ChicoLiebl/pressure-acquisition-system/README.md

# pressure-acquisition-system

Acquisition system for a piezoelectric pressure sensor, model 601A from Kistler. This system was developed as my electrical engineering graduation project.
