ChicoLiebl/pressure-acquisition-system/Hardware/local-lib/cad_models/hlk-pm01--3DModel-STEP-56544.STEP

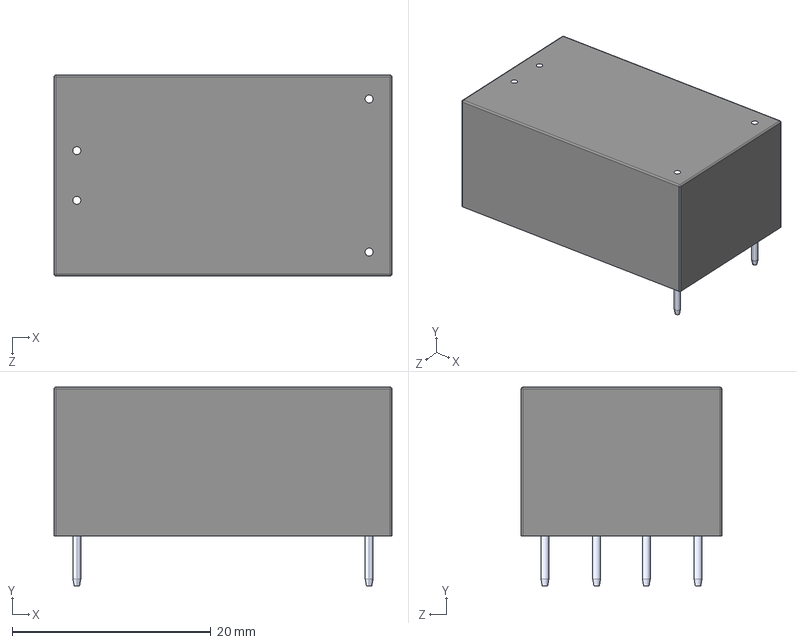
[picture p1: CAD file, 2021-12-02]
Hardware/local-lib/cad_models/hlk-pm01--3DModel-STEP-56544.STEP
34.0 x 20.0 x 20.2 mm
