ChicoLiebl/pressure-acquisition-system/Hardware/local-lib/cad_models/Common-mode-choke.STEP

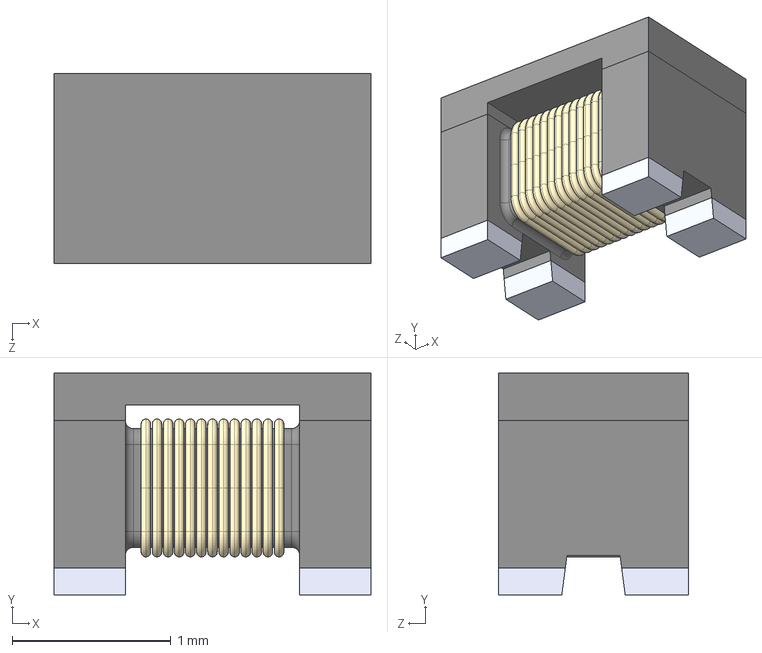
[picture p2: CAD file, 2021-12-02]
Hardware/local-lib/cad_models/Common-mode-choke.STEP
2.00 x 1.40 x 1.20 mm
