ChicoLiebl/pressure-acquisition-system/Hardware/local-lib/cad_models/BNC7T-J-P-HN-RA-BH1.stp

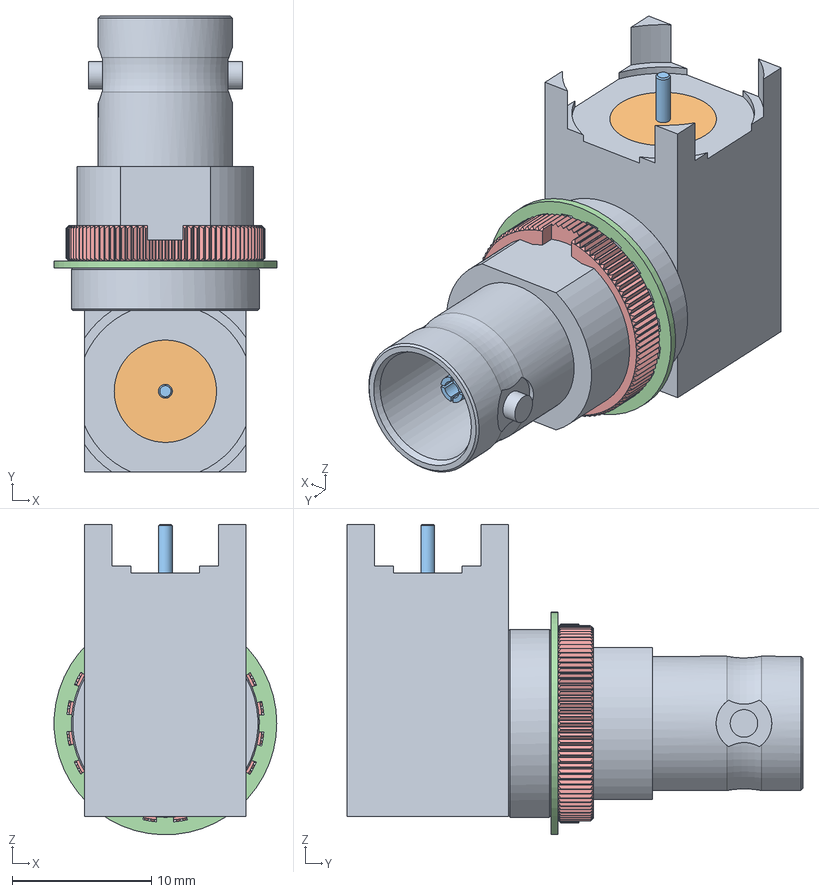
[picture p3: CAD file, 2021-12-02]
Hardware/local-lib/cad_models/BNC7T-J-P-HN-RA-BH1.stp
16.0 x 32.8 x 22.3 mm
_BNC7T-G-P-HN-RA-BH1_s
_BNC7T-G-P-HN-RA-BH1_i
_BNC7T-G-P-HN-RA-BH1_p
_BNC7T-G-P-HN-RA-BH1_w
_BNC7T-G-P-HN-RA-BH1_n
