ChicoLiebl/pressure-acquisition-system/Hardware/local-lib/cad_models/ESP32-WROVER-I.step

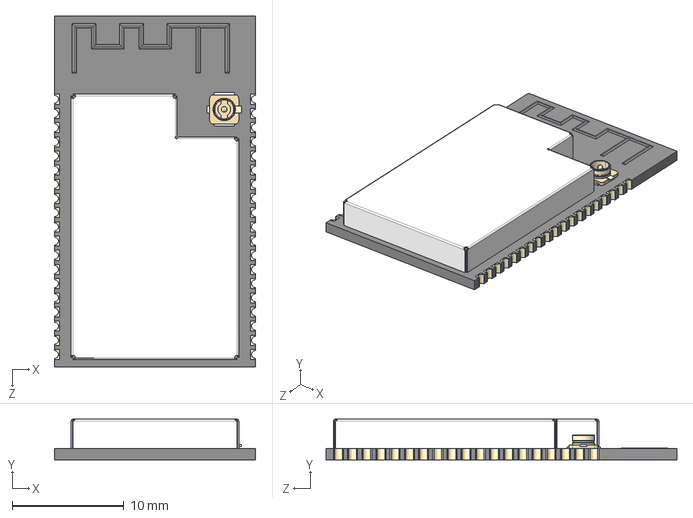
[picture p4: CAD file, 2021-12-02]
Hardware/local-lib/cad_models/ESP32-WROVER-I.step
18.0 x 3.65 x 31.4 mm
