ChicoLiebl/pressure-acquisition-system/Hardware/REV00/stencil.stl

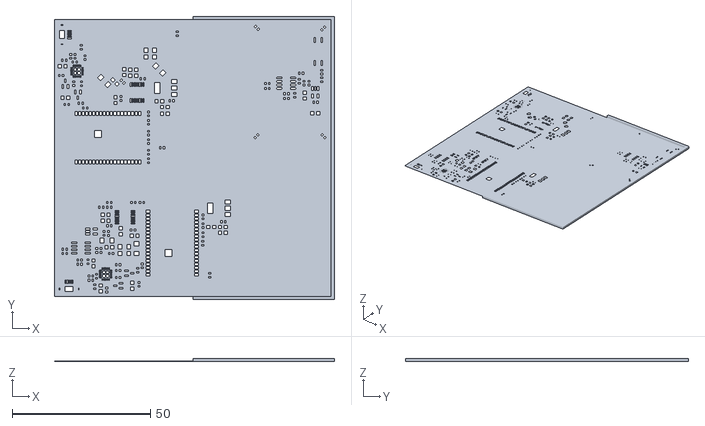
[picture p5: CAD file, 2021-12-02, an earlier design]
Hardware/REV00/stencil.stl
101.2 x 102.4 x 1.20
