ChicoLiebl/pressure-acquisition-system/Hardware/V2-main-board/V2-main-board.kicad_pcb

## KiCad design Hardware/V2-main-board/V2-main-board.kicad_pcb (2021-12-02)

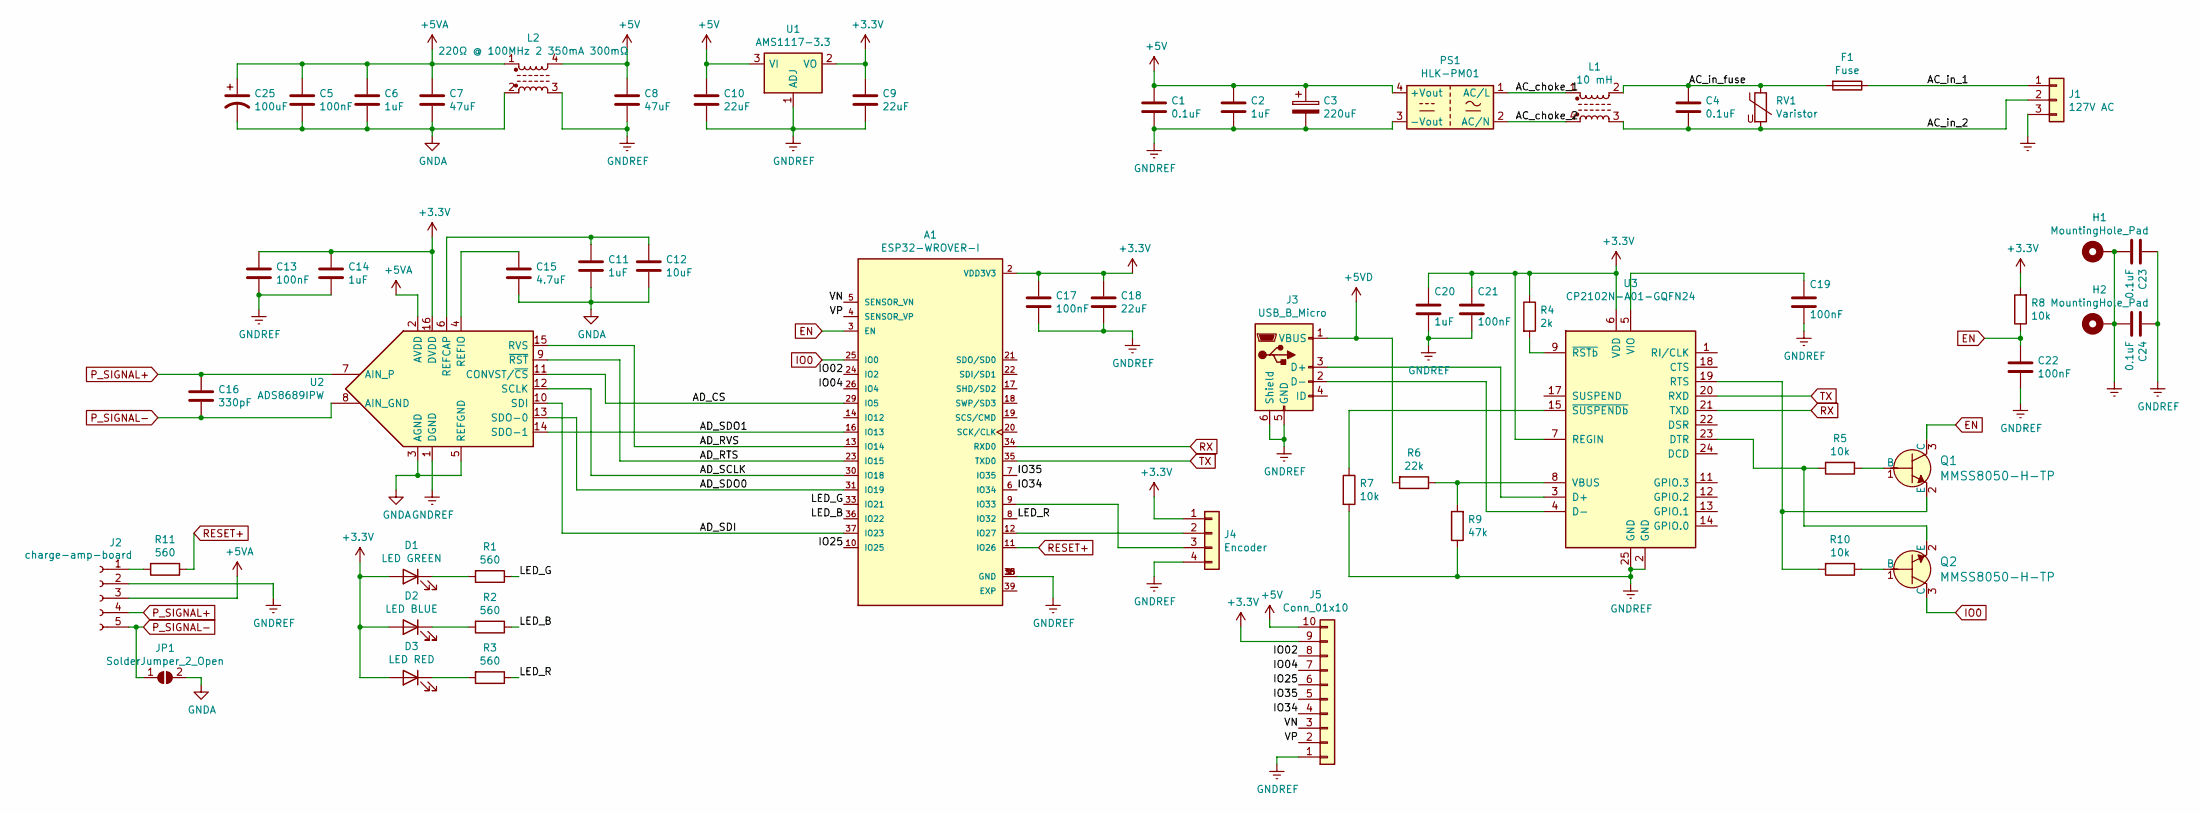
[picture p6: schematic V2-main-board.sch]

Parts:
A1: ESP32-WROVER-I; XCVR_ESP32-WROVER-I; DIGI-KEY_PART_NUMBER 1904-1008-1-ND
C1, C23, C24: 0.1uF; 0603
C2, C6, C11, C14, C20: 1uF; 0805
C3: 220uF; CP_Radial_D10.0mm_P2.50mm
C4: 0.1uF; C_Rect_L9.0mm_W3.8mm_P7.50mm_MKT
C5, C13, C17, C19, C21, C22: 100nF; 0603
C7, C8: 47uF; 1206
C9, C10, C18: 22uF; 0805
C12: 10uF; 0805
C15: 4.7uF; 0805
C16: 330pF; 0603
C25: 100uF; CP_Radial_D5.0mm_P2.00mm
D1: LED GREEN; 0603
D2: LED BLUE; 0603
D3: LED RED; 0603
F1: Fuse; Fuse_BelFuse_0ZRE0025FF_L9.6mm_W3.8mm
H1, H2: MountingHole_Pad; TestPoint_Plated_Hole_D3.0mm
J1: 127V AC; AC-Input
J2: charge-amp-board; GX16-5P
J3: USB_B_Micro; USB_Micro-AB_Molex_47590-0001
J4: Encoder; PinHeader_1x04_P1.27mm_Vertical
J5: Conn_01x10; PinHeader_1x10_P2.54mm_Vertical
JP1: SolderJumper_2_Open; SolderJumper-2_P1.3mm_Open_RoundedPad1.0x1.5mm
L1: 10 mH; UU9.8
L2: 220Ω @ 100MHz 2 350mA 300mΩ; ACM3225-2P
PS1: HLK-PM01; Converter_ACDC_HiLink_HLK-PMxx
Q1, Q2: MMSS8050-H-TP; SOT-23-3; MPN MMSS8050-H-TP; Digi-Key_PN MMSS8050-H-TPMSCT-ND
R1, R2, R3, R11: 560; 0603
R4: 2k; 0603
R5, R7, R8, R10: 10k; 0603
R6: 22k; 0603
R9: 47k; 0603
RV1: Varistor; RV_Disc_D12mm_W3.9mm_P7.5mm
U1: AMS1117-3.3; SOT-223-3_TabPin2
U2: ADS8689IPW; TSSOP-16_4.4x5mm_P0.65mm
U3: CP2102N-A01-GQFN24; QFN-24-1EP_4x4mm_P0.5mm_EP2.6x2.6mm

Connections:
+3V3: A1.2 (VDD3V3), C9.1, C13.1, C14.1, C17.1, C18.1, C20.1, C21.1, D1.2 (A), D2.2 (A), D3.2 (A), J4.1, J5.9, R4.1, R8.2, U1.2 (VO), U2.16 (DVDD), U3.6 (VDD), U3.7 (REGIN)
+5V: C1.1, C2.1, C3.1, C8.1, C10.1, J5.10, L2.4, PS1.4 (+Vout), U1.3 (VI)
+5VA: C5.1, C6.1, C7.1, C25.1, J2.3, L2.1, U2.2 (AVDD)
+5VD: J3.1 (VBUS), R6.2
/AC_choke_1: L1.1, PS1.1 (AC/L)
/AC_choke_2: L1.4, PS1.2 (AC/N)
/AC_in_1: F1.1, J1.1
/AC_in_2: C4.2, J1.2, L1.3, RV1.2
/AC_in_fuse: C4.1, F1.2, L1.2, RV1.1
/AD_CS: A1.29 (IO5), U2.11 (CONVST/~CS)
/AD_RTS: A1.23 (IO15), U2.9 (~RST)
/AD_RVS: A1.13 (IO14), U2.15 (RVS)
/AD_SCLK: A1.30 (IO18), U2.12 (SCLK)
/AD_SDI: A1.37 (IO23), U2.10 (SDI)
/AD_SDO0: A1.31 (IO19), U2.13 (SDO-0)
/AD_SDO1: A1.16 (IO13), U2.14 (SDO-1)
/IO02: A1.24 (IO2), J5.8
/IO04: A1.26 (IO4), J5.7
/IO25: A1.10 (IO25), J5.6
/IO34: A1.6 (IO34), J5.4
/IO35: A1.7 (IO35), J5.5
/LED_B: A1.36 (IO22), R2.1
/LED_G: A1.33 (IO21), R1.1
/LED_R: A1.8 (IO32), R3.1
/VN: A1.5 (SENSOR_VN), J5.3
/VP: A1.4 (SENSOR_VP), J5.2
EN: A1.3 (EN), C22.1, Q1.3 (C), R8.1
Earth: C23.2, C24.2, H1.1, H2.1, J1.3
GNDA: C5.2, C6.2, C7.2, C11.2, C12.2, C15.2, C25.2, JP1.2 (B), L2.2, U2.3 (AGND), U2.5 (REFGND)
GNDREF: A1.1 (GND), A1.15 (GND), A1.38 (GND), C1.2, C2.2, C3.2, C8.2, C9.2, C10.2, C13.2, C14.2, C17.2, C18.2, C19.2, C20.2, C21.2, C22.2, C23.1, C24.1, J2.2, J3.5 (GND), J3.6 (Shield), J4.4, J5.1, L2.3, PS1.3 (-Vout), R7.2, R9.1, U1.1 (ADJ), U2.1 (DGND), U3.2 (GND), U3.25 (GND)
IO0: A1.25 (IO0), Q2.3 (C)
unnamed: A1.9 (IO33), J4.3
unnamed: A1.12 (IO27), J4.2
unnamed: C11.1, C12.1, U2.6 (REFCAP)
unnamed: C15.1, U2.4 (REFIO)
unnamed: C19.1, U3.5 (VIO)
unnamed: D1.1 (K), R1.2
unnamed: D2.1 (K), R2.2
unnamed: D3.1 (K), R3.2
unnamed: J2.1, R11.2
unnamed: J3.2 (D-), U3.4 (D-)
unnamed: J3.3 (D+), U3.3 (D+)
unnamed: Q1.1 (B), R5.1
unnamed: Q1.2 (E), R10.2, U3.19 (RTS)
unnamed: Q2.1 (B), R10.1
unnamed: Q2.2 (E), R5.2, U3.23 (DTR)
unnamed: R4.2, U3.9 (~RSTb)
unnamed: R6.1, R9.2, U3.8 (VBUS)
unnamed: R7.1, U3.15 (~SUSPENDb)
P_SIGNAL+: C16.1, J2.4, U2.7 (AIN_P)
P_SIGNAL-: C16.2, J2.5, JP1.1 (A), U2.8 (AIN_GND)
RESET+: A1.11 (IO26), R11.1
RX: A1.34 (RXD0), U3.21 (TXD)
TX: A1.35 (TXD0), U3.20 (RXD)

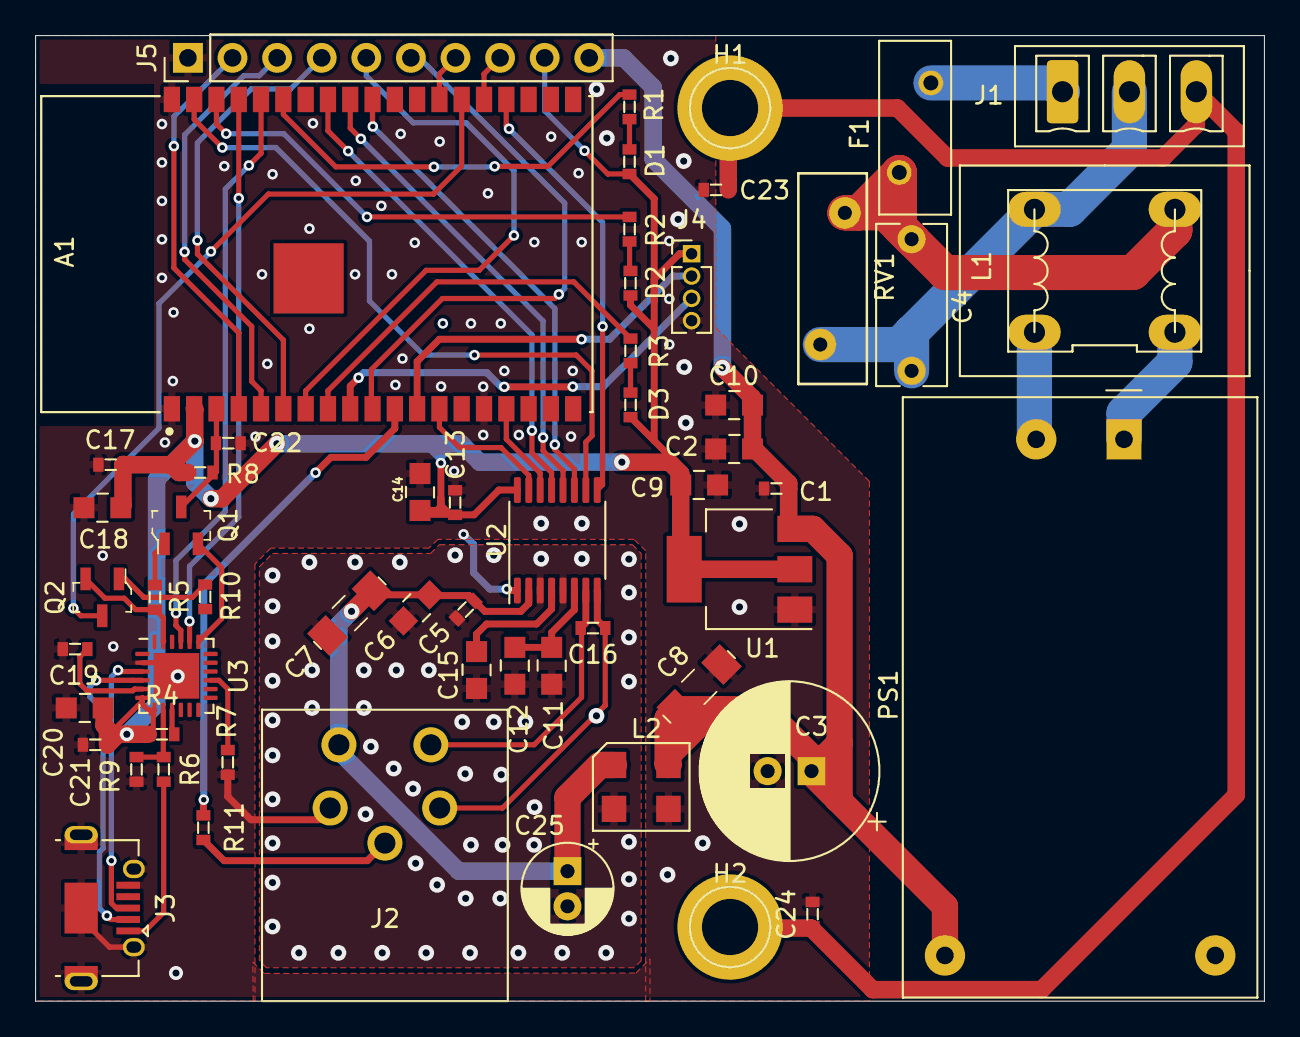
[picture p7: board V2-main-board.kicad_pcb from above]

Board: 4 copper layers, 70.0 x 55.0 mm, 58 parts (1 on the bottom side), 54 nets.
