ChicoLiebl/pressure-acquisition-system/Hardware/V2-charge-amp/V2-charge-amp.kicad_pcb

## KiCad design Hardware/V2-charge-amp/V2-charge-amp.kicad_pcb (2021-12-02)

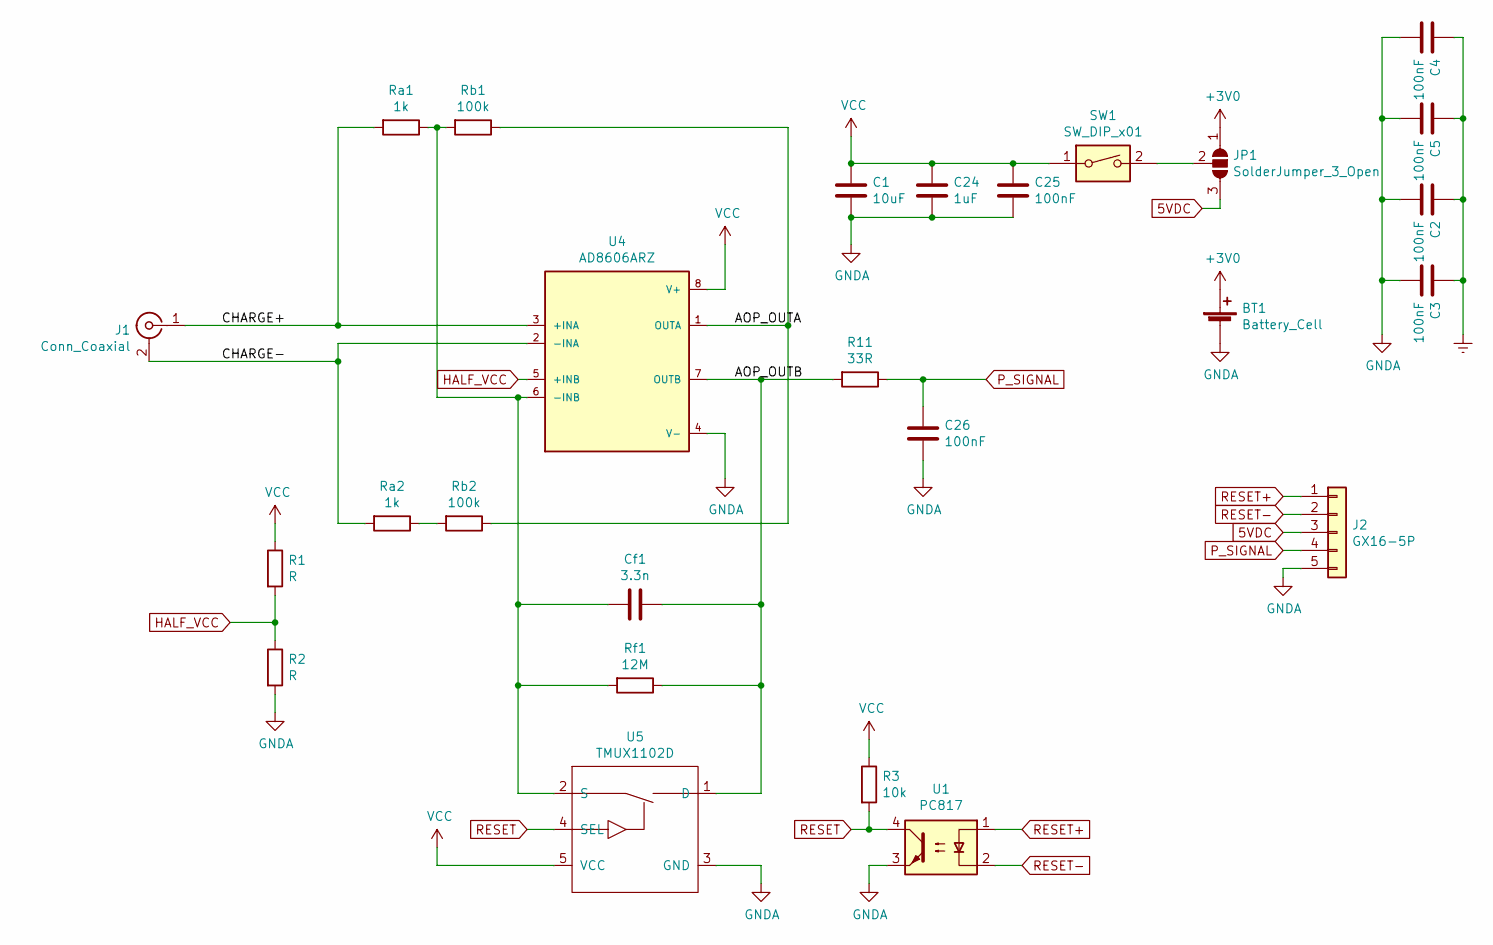
[picture p8: schematic V2-charge-amp.sch]

Parts:
BT1: Battery_Cell; PinHeader_1x02_P2.54mm_Vertical
C1: 10uF; 0805
C2, C3, C4, C5, C25, C26: 100nF; 0603
C24: 1uF; 0805
Cf1: 3.3n; 0603
J1: Conn_Coaxial; BNC_Header
J2: GX16-5P
JP1: SolderJumper_3_Open; SolderJumper-3_P1.3mm_Open_RoundedPad1.0x1.5mm
R1, R2: R; 0603
R3: 10k; 0603
R11: 33R; 0603
Ra1, Ra2: 1k; 0603
Rb1, Rb2: 100k; 0603
Rf1: 12M; 0603
SW1: SW_DIP_x01; PinHeader_1x02_P2.54mm_Vertical
U1: PC817
U4: AD8606ARZ; SOIC-8_3.9x4.9mm_P1.27mm; PARTREV O
U5: TMUX1102D; SOT-23-5_HandSoldering

Connections:
5VDC: J2.3, JP1.3 (B)
+3V0: BT1.1 (+), JP1.1 (A)
/AOP_OUTA: Rb1.1, Rb2.1, U4.1 (OUTA)
/AOP_OUTB: Cf1.1, R11.2, Rf1.1, U4.7 (OUTB), U5.1 (D)
/CHARGE+: J1.1 (In), Ra1.2, U4.3 (+INA)
/CHARGE-: J1.2 (Ext), Ra2.2, U4.2 (-INA)
Earth: C2.1, C3.1, C4.1, C5.1
GNDA: BT1.2 (-), C1.2, C2.2, C3.2, C4.2, C5.2, C24.2, C25.2, C26.2, J2.5, R2.2, U1.3, U4.4 (V-), U5.3 (GND)
HALF_VCC: R1.2, R2.1, U4.5 (+INB)
unnamed: Cf1.2, Ra1.1, Rb1.2, Rf1.2, U4.6 (-INB), U5.2 (S)
unnamed: JP1.2 (C), SW1.2
unnamed: Ra2.1, Rb2.2
P_SIGNAL: C26.1, J2.4, R11.1
RESET: R3.2, U1.4, U5.4 (SEL)
RESET+: J2.1, U1.1
RESET-: J2.2, U1.2
VCC: C1.1, C24.1, C25.1, R1.1, R3.1, SW1.1, U4.8 (V+), U5.5 (VCC)

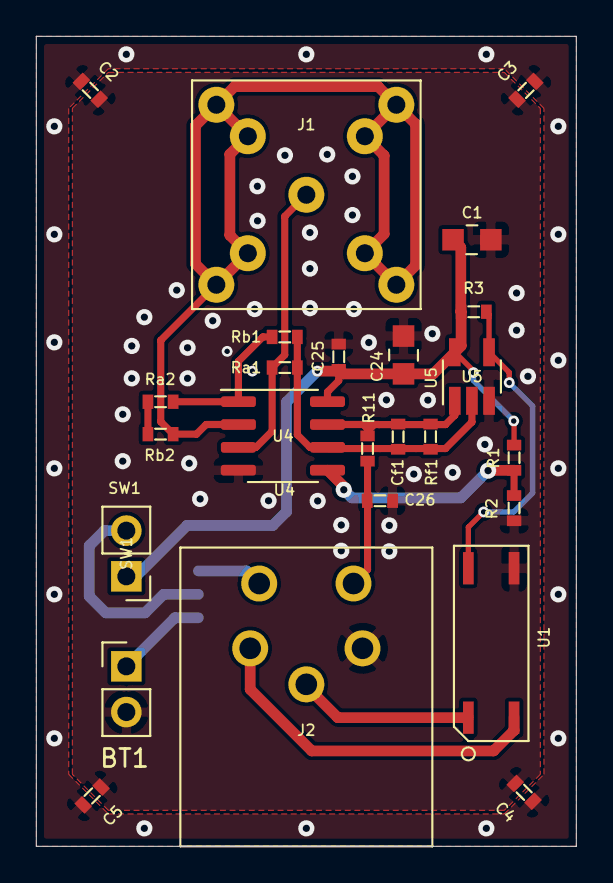
[picture p9: board V2-charge-amp.kicad_pcb from above]

Board: 4 copper layers, 30.0 x 45.0 mm, 26 parts (1 on the bottom side), 17 nets.
