ChicoLiebl/pressure-acquisition-system/(commit log)

2021-12-02 added pcb first revision
    [All_boards.kicad_pcb, BNC7T-J-P-HN-RA-BH1.stp, Common-mode-choke.STEP, ESP32-WROVER-I.step, MainBoard.sch, V2-charge-amp.csv, V2-charge-amp.kicad_pcb, V2-charge-amp.sch]
2021-12-03 added specific libs
    [BNC7T-J-P-HN-RA-BH1.stp, Common-mode-choke.STEP, ESP32-WROVER-I.step, hlk-pm01--3DModel-STEP-56544.STEP]
2021-12-03 fixed paths and updated name
    [V1.kicad_pcb, V1.sch, V2-charge-amp.csv, V2-main-board.csv, v1.kicad_pcb]
2021-12-04 changed 100n to 0.1u
    [V1.sch]
2021-12-21 changed udp to tcp socket
2021-12-21 finished tcp socket routine
2022-03-10 updated spi code
2022-03-13 implemented hardware timer
2022-04-10 added ble conf and protobuf
    [configuration.h, partitions.csv]
2022-04-16 finished configration and added fft plot
    [configuration.h]
