ChicoLiebl/pressure-acquisition-system/(notices)

Notices in the files:
Hardware/local-lib/cad_models/BNC7T-J-P-HN-RA-BH1.stp:
FILE_NAME( 'e:/temp/worker_170/temp/exporttempdir_2976_351_K7orS/format_0/BNC7T-J-P-HN-RA-BH1.stp', '2021-09-28T00:56:55', ( 'License CC BY-ND 4.0' ), ( 'CADENAS' ), ' ', 'PARTsolutions', ' ' );
